sametyildirima/FosFos-AG/README.md

# FosFos-AG
EE463-Hardware Project

This Repo Includes Detailed Information About Hardware Design Project



Video Link: https://www.youtube.com/watch?v=irYZJVu4fXo&feature=youtu.be
