sametyildirima/FosFos-AG/Latex_Report/ee463_hardware.pdf

# EE463 Static Power Conversion AC to DC Motor Drive Project

Ozan Can ˙IY˙IER
Samet YILDIRIM
Furkan KARACABEY

January 2019

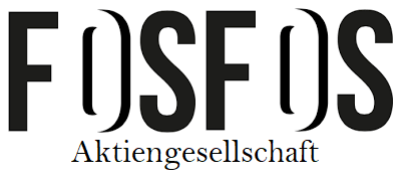
[picture p32: figure]

1

## Contents

1 Introduction | 3
2 Project Description | 3
3 Design Specifications | 7
4 Simulation Results | 8
5 Component Selection | 11
6 Test Results | 12
7 Demonstration Results | 13
8 Cost Analysis | 14
9 Conclusion | 15
10 References | 15

## 1 Introduction

As Static Power Conversion Course project, we are assigned to design an AC to DC Motor Driver which can drive a specified DC motor under full load by controlling the speed. AC input of the system is supplied by a auto-transformer (i.e variac). By using the variac this way, we forced it to act as a fixed transformer. Hence, our product will be able to used industrial purposes.
Power electronics is an area which combines high and low voltages. In our project, we deal with both high and low voltages. By designing our circuit, the most challenging part was controlling the IGBT, because we fed the gate of IGBT with Arduino which drives currents in millimetre level. Unlike control part, we drive the rest of the circuit in 10-20 Ampere levels. In order to protect our Arduino, we used some protection circuits. In addition, the other problem that we faced during design process is over-heating. Because the circuit operates under high voltage and current conditions. All components were on the border of the over-heating. Hence, we added some extra components to prevent over-heating.
During design process, we considered all of the problems and other possible problems that we can face during test. This reports includes related information about problem statement, possible solution approaches, design specifications, simulation,test and demonstration results.

## 2 Project Description

In this project, FOSFOS AG is assigned to drive a Crompton Parkinson DC Motor which is indicated at figure 1.


Figure 1: Crompton Parkinson DC Motor

The ratings of the DC Motor is indicated at following table; Table 1: The Specifications of DC Motor

The input of the project is specified as three or single phase AC grid supplied by variac. The output voltage of the design should be higher than 180Vdc. In addition to these features, the system should (9)control the speed of motor. Heating and isolation conditions of the system also should be sufficient for long term usages.

### 2.1 Solution Approaches

This project has three main topologies to control-drive DC motor. These are three-phase thyristor rectifier, one-phase thyristor rectifier and three-phase diode rectifier with a buck converter. This part of the report includes comparison of these topologies with advantages and disadvantages, simulations of them. Simulations are done by Simulink software. Simulations provide just an example of these topologies with loads.

### 2.1.1 Three-Phase Thyristor Rectifier

This topology which can be seen in figure 2 below includes 6 thyristors. Thyristors must be opened by different gate signals so a fixed delay between the gates is required for switching signals. These gate signals are also used to control DC output.

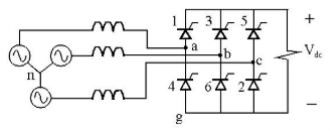
[picture p33: figure]

Figure 2: Three-Phase Thyristor Rectifier

To analyze this topology FosFos AG created a design example on Simulink. This design includes a R load and thyristors have 30-degree firing angle. Figure 3 and 4 shows the schematic of the three-phase thyristor rectifier and output voltage waveform of it.

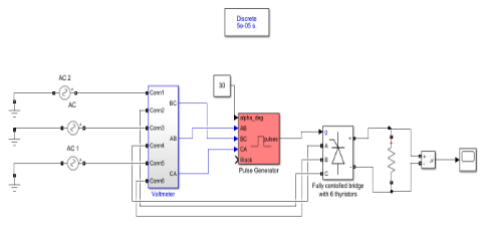
[picture p34: figure]

Figure 3: Simulink Schematic of the Three-Phase Thyristor Rectifier


Figure 4: Output Voltage Waveform of the Three-Phase Thyristor Rectifier

### 2.1.2 One-Phase Thyristor Rectifier

This topology which can be seen in figure 5 below includes 4 thyristors. DC output voltage can be controlled by using two thyristors per half-cycle. Q1-Q4 and Q2-Q3 thyristors are firing together for positive and negative cycle.

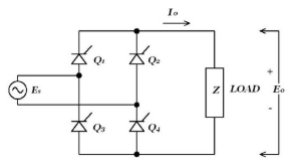
[picture p35: figure]

Figure 5: One-Phase Thyristor Rectifier

Simulink analysis of this topology which is shown in figure 6 was done with R-L Load and the output voltage which includes comparison of input and output can be seen in figure 7.


Figure 6: Simulink Schematic of the One-Phase Thyristor Rectifier


Figure 7: Input-Output Voltage Waveform of the One-Phase Thyristor Rectifier

### 2.1.3 Three-Phase Diode Rectifier & Buck Converter

This topology which can be seen in figure 8 below includes 6 diodes; a switch element which can be Mosfet, IGBT i.e; a freewheeling diode which is conducted when the switch is off; and a LC filter which is used for getting smooth output voltage. Output DC voltage cannot be controlled by bridge rectifier, but it can be controlled by driving switch element’s gate.

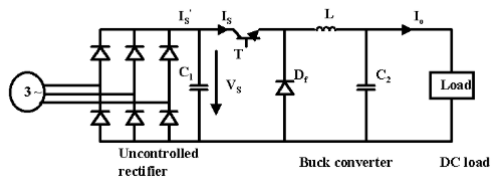
[picture p36: figure]

Figure 8: Three-Phase Diode Rectifier with Buck Converter

Simulation of this topology was done with two filters which are DC Link capacitor and LC filter and an R-L Load. Duty Cycle was selected %45 and the switching frequency was 7800kHz. The schematic of the simulation and graph of the output voltage waveform are shown in figure 9 and 10.


Figure 9: Simulink Schematic of the Three-Phase Diode Rectifier with Buck Converter


Figure 10: Output Voltage Waveform of the Three-Phase Diode Rectifier with Buck Converter

### 2.2 Comparison of Solution Approaches

Table 2:Advantages and Disadvantages of Solution Approaches


## 3 Design Specifications

FosFos AG plans to design cheaper and efficient project for driving DC Motor. Project design of FosFos AG includes a three-phase diode rectifier, a DC link capacitor which is used for filtering the rectifier output, a switch element and a freewheeling diode.In addition to these parts, some modifications are applied to prevent possible issues.For example, LC filter of the output of the buck converter is not included because motor can be considered not only a load but also a filter. The other example of this is in order to prevent over-heating issues power diode and IGBT is connected to a heatsink. The other modification applied is inserting a snubber circuit to prevent overshoot voltages occuring between collector and emittor. To control gate of the switch element, Arduino Nano is selected because it is enough to give switching frequency and size of the component is very suitable for simple design.
Reasons of the rectifier selection can be seen below.
- FosFos AG plans to use smaller passive elements. (One-Phase Thyristor is eliminated)
- FosFos AG plans to design easier control circuit. (Three-Phase Thyristor is eliminated)

## 4 Simulation Results

After deciding three phase diode rectifier and buck converter topology; we focused on simulations in order to determine exact values of each component. We tried to use the most realistic values of each component during simulations because the deviation from ideal results can be very large in real life applications. The simulation circuits and results are indicated at following sections;

### 4.1 Three-Phase Diode Rectifier

Diode bridge rectifier basically operates according to ON/OFF configurations of the diodes. The rectifier topology is indicated at following figure. Two diodes(i.e. one from above and below part of figure 11) conducts at same time.

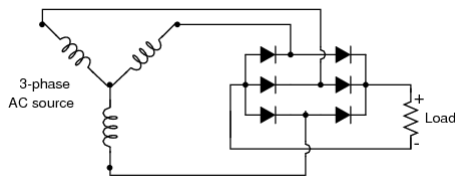
[picture p37: figure]

Figure 11: Rectifier Topology

These changes on conduction determine output voltage waveform. The output waveform operation can be seen from following figure 12. Because the output value of the rectifier is higher than our expected output. We have connected a buck converter to arrange output voltage level. The buck converter operation will be covered at following section.

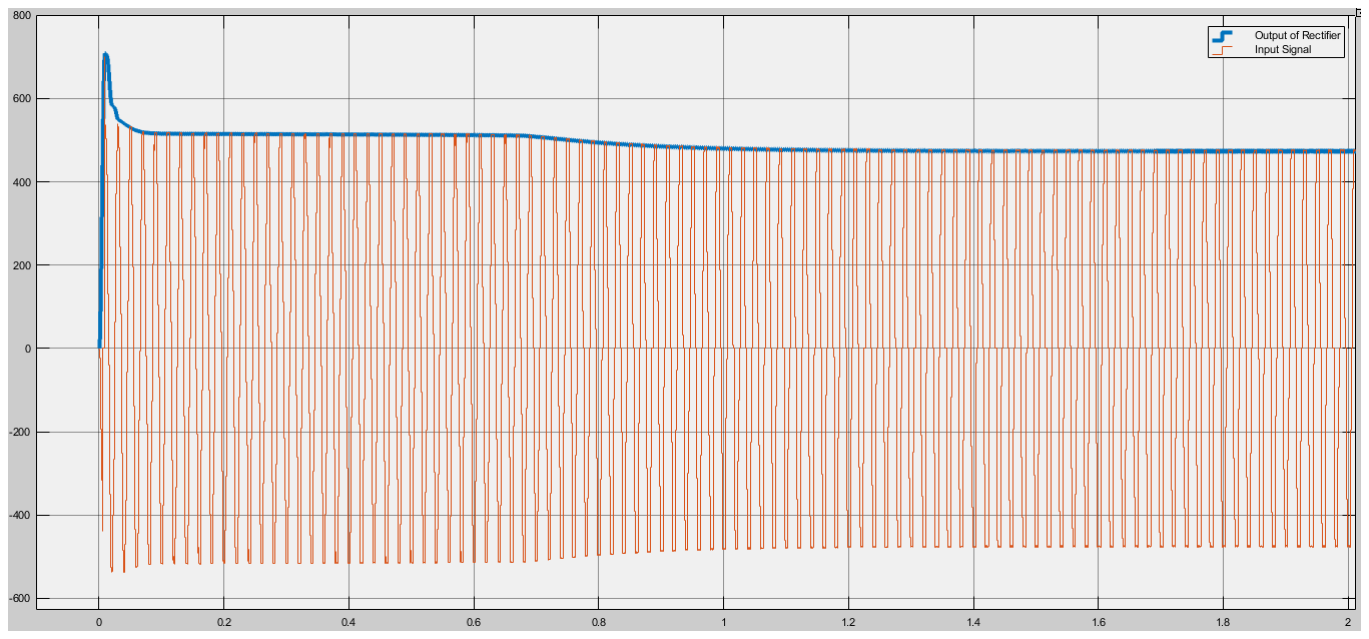
[picture p38: figure]

Figure 12: Rectifier Operation

### 4.2 Buck Converter

The reason of using buck converter in our circuit, which is shown in figure 13 is setting the output voltage to a optimum level by controlling the switching of the IGBT.

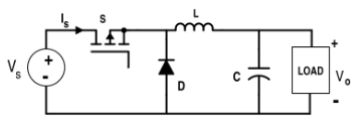
[picture p39: figure]

Figure 13: Buck Converter Topology

The buck converter’s working principle bases on duty cycle of the switching waveform of gate signal. During switch is ON period, the diode goes OFF and we charge our inductor. After then, we discharge our inductor on load and diode during switch is OFF period. The simulation result is indicated at following figure;


Figure 14: Buck Converter Operation

### 4.3 Overall System Results

After obtaining the operations of each subunit; we combined them as an overall system which can be seen from figure 15. The following figures indicates the input output relations of the circuit for different conditions;

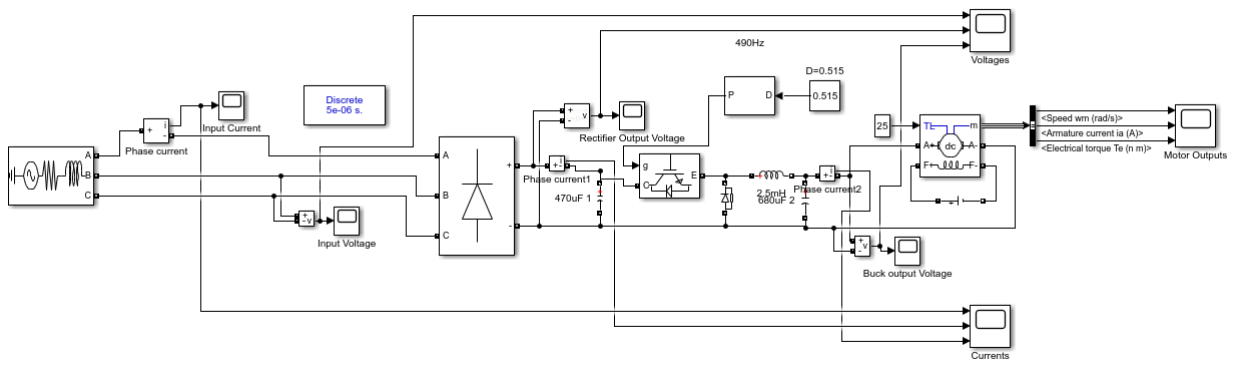
[picture p40: figure]

Figure 15: Overall Circuit

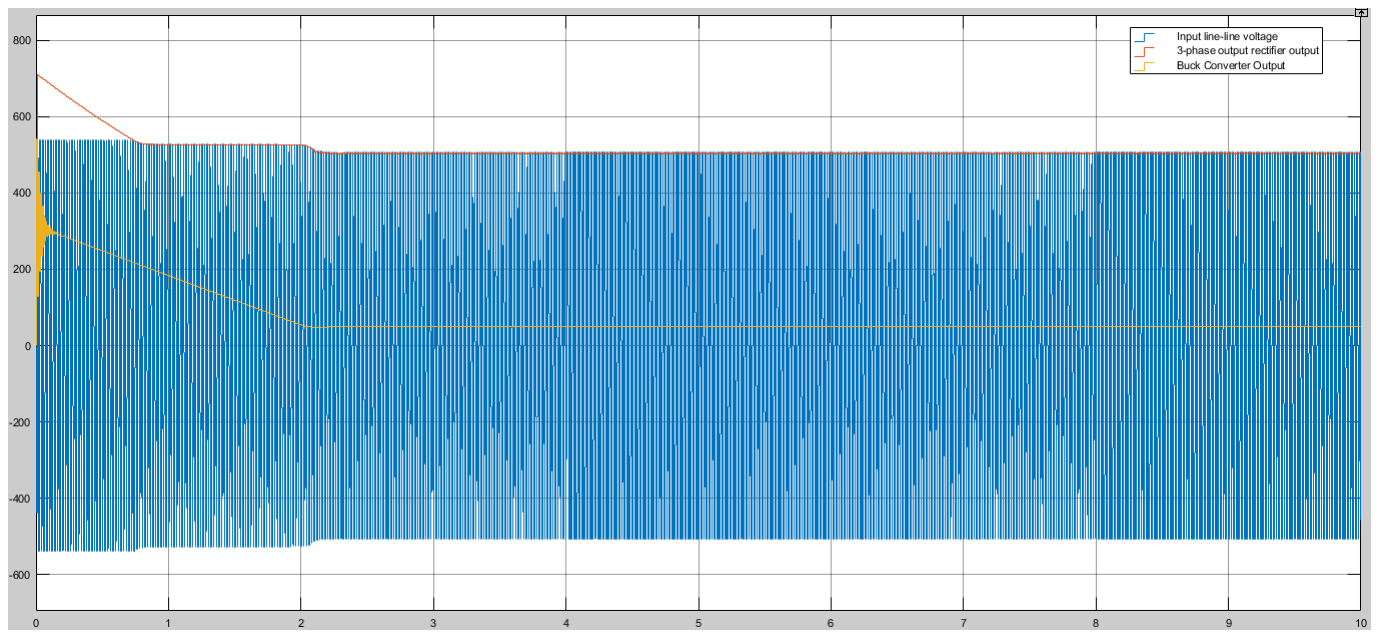
[picture p41: figure]

Figure 16: % 10 Duty Cycle Voltage Output


Figure 17: % 50 Duty Cycle Voltage Output

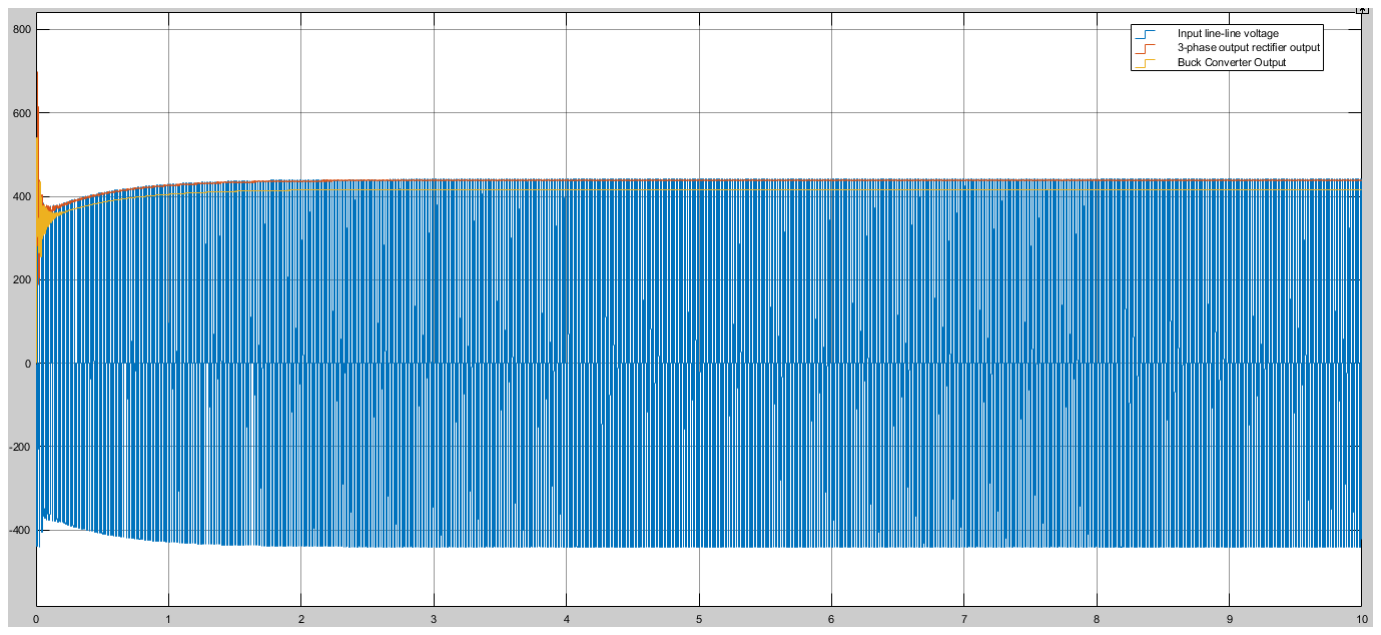
[picture p42: figure]

Figure 18: % 95 Duty Cycle Voltage Output

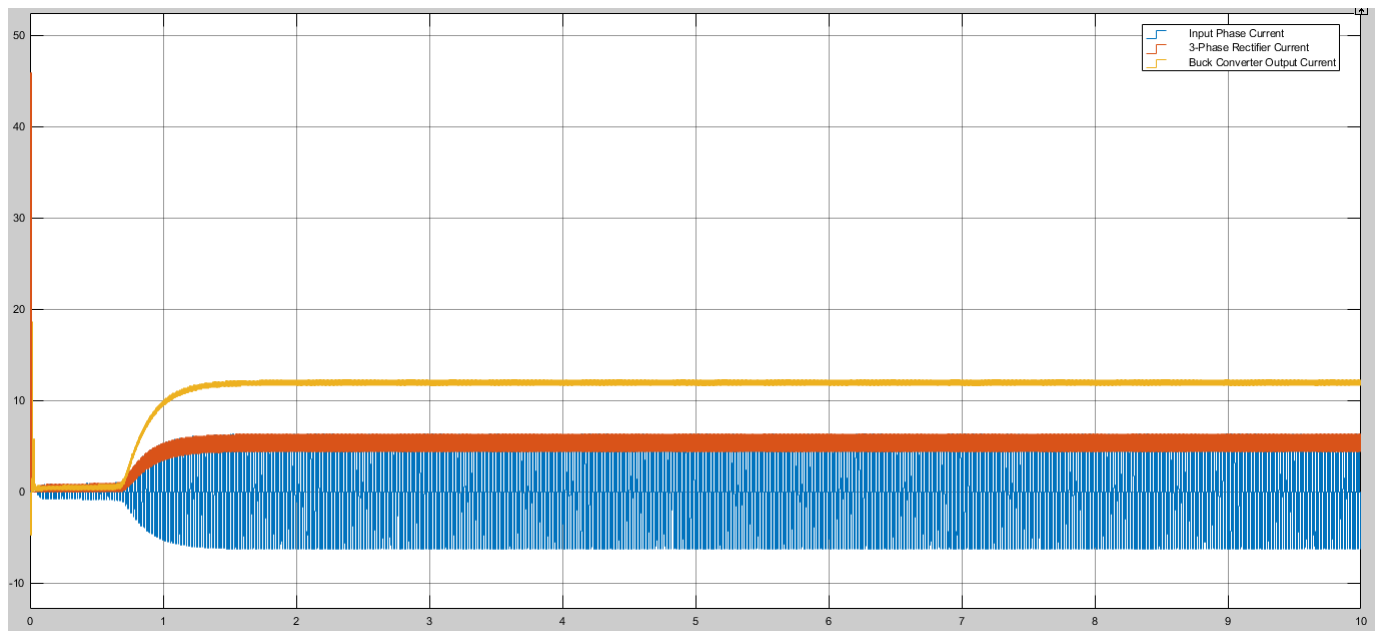
[picture p43: figure]

Figure 19: Current Analysis of Simulation Circuit for % 50 Duty Cycle


Figure 20: Speed-Armature Current-Electrical Torque vs Time Graph

## 5 Component Selection

According to the simulation results we have determined to get components indicated at table 3. While buying the components we were flexible about parameters, because some components are hard to find in local shops.
Table 3: Component List

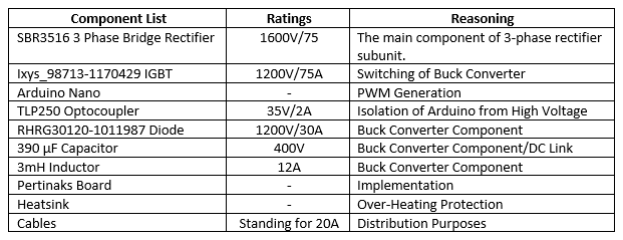
[picture p44: figure]

*For more detailed information, please see our Github repository’s datasheets section.

## 6 Test Results

After component selections; we implemented the circuit on board(can be seen from figure 21) and applied some tests. As seen in figure 22; when output voltage of full bridge rectifier is 232 V; Duty Cycle, Collector to Emitter Voltage and Output Voltage is given in figure 23.


Figure 21: The product during test process


Figure 22: The Measured Output Voltage at Rectifier


Figure 23: The Output Voltage Waveforms

## 7 Demonstration Results

At the final day of the project, we presented our project to the expert. The product is worked well and managed to complete some task such as full loaded working for a while. The following figures show outputs taken during demonstration.


Figure 24: Field and Armature Voltage at Full Load


Figure 25: Armature Current at Full Load Condition


Figure 26: Load Voltage and Load Current


Figure 27: Load Voltage, Current and Power Waveforms

## 8 Cost Analysis

During test process, we have faced lots of problems as expected. Fortunately, we had spare components in order to replace with damaged ones. For example, because of overshoots at VCE voltage, we burnt 4 IGBTs. In addition, we burnt one diode because of high switching frequency. The other problem that we faced is because of a unexpected short circuit, the TLP250 is burnt. Therefore, all these failures became good experiences for us. The finalized version of cost analysis can be seen from following table;
Table 4: Cost Analysis

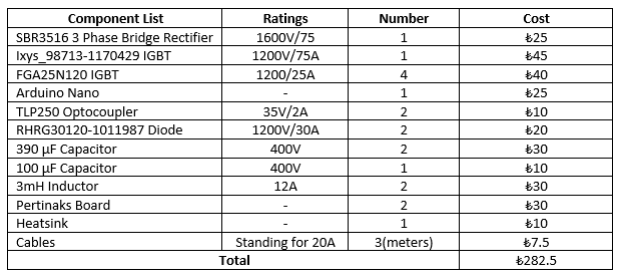
[picture p45: figure]

## 9 Conclusion

We are asked to produce an AC to DC Motor Driver in order to drive a specified DC motor under full load. The speed of the motor also should be controlled by hand. In demonstration, the project is successfully delivered by qualified engineers of FOSFOS Actiengesellschaft.
During this process, we divided our project into subunits to increase ease of understanding concepts. After understanding the project clearly, we went MATLAB/Simulink environment and simulated our design. According to the design, the components of the product is determined. The most challenging part of the project was implementation and testing processes. We have faced too many problems during that period because simulation world is all ideal. The one and most important issue that we faced during testing is over-heating problem. Because we did not use thermal paste between IGBT and heatsink, we lost 4 IGBT’s. The other problem was in simulations that the snubber values of the IGBT is set to be ideal, but in real life it is not. Because of inductive effects in cables, we could not handle this problem at first and lost some IGBTs due to overshooting at voltage. The last problem that we faced is parasitic elements caused some problems. After then, we learned that a practical solution which can solve this problem. By connecting a little capacitor between collector of IGBT and anode of the diode, problems could be solved.
Although project is tiring and hard to create, we learned too many things to use our future engineering life. This project is also helped us to understand the consepts of EE463 Static Power Conversion Course. Finally we would like to thank our Instructors, power elctronics M.S. Students and laboratory technician for their helps.

## 10 References

MOHAN, N. (2017). Power Electronics JOHN WILEY & Sons. http://keysan.me/ee463/
https://github.com/sametyildirima/FosFos-AG.git

## Appendices

Arduino Code for PWM Generation

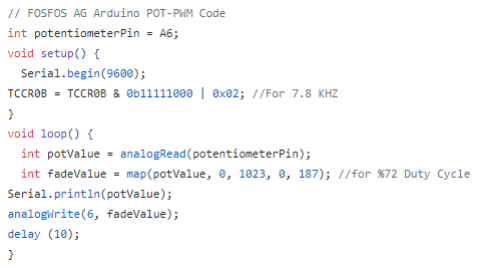
[picture p46: figure]

Datasheets
https://github.com/sametyildirima/FosFos-AG/blob/master/Datasheets/2282907.pdfhttps://github.com/sametyildirima/FosFos-AG/blob/master/Datasheets/2822 7668536.pdf https://github.com/sametyildirima/FosFos-AG/blob/master/Datasheets/FGA25N120.pdfhttps://github.com/sametyildirima/FosFos-AG/blob/master/Datasheets/FGH20N60SFD-D.PDFh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 datasheet en 20170821.pdf https://github.com/sametyildirima/FosFos-AG/blob/master/Datasheets/ixys 98713-1170429.pdf
Video Link(In Turkish) XXXXXXXXXXXXXXXXXXx
