sametyildirima/FosFos-AG/Latex_Report/buck.PNG

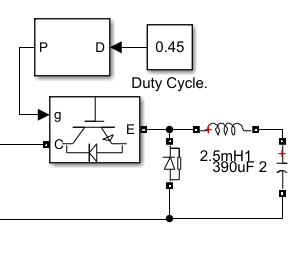
Latex_Report/buck.PNG
