sametyildirima/FosFos-AG/Latex_Report/ucfazdiodecct.PNG

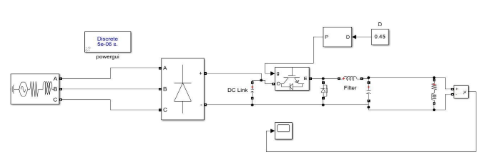
Latex_Report/ucfazdiodecct.PNG
