sametyildirima/FosFos-AG/Latex_Report/ucfazrect.PNG

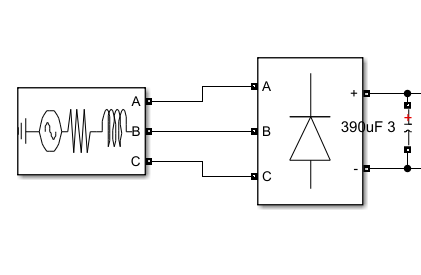
Latex_Report/ucfazrect.PNG
