sametyildirima/FosFos-AG/simulations/One_Phase_Thyristor_Rectifier/Input_Output Voltage.JPG

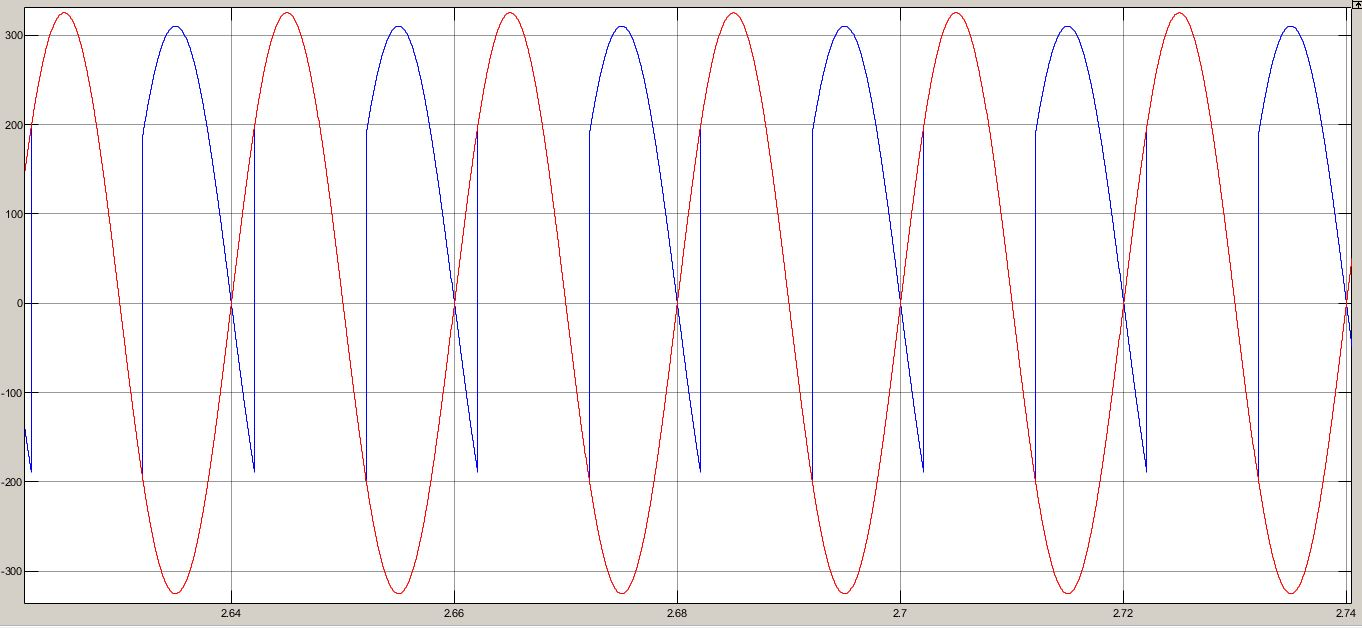
simulations/One_Phase_Thyristor_Rectifier/Input_Output Voltage.JPG
