sametyildirima/FosFos-AG/simulations/One_Phase_Thyristor_Rectifier/Schematic.JPG

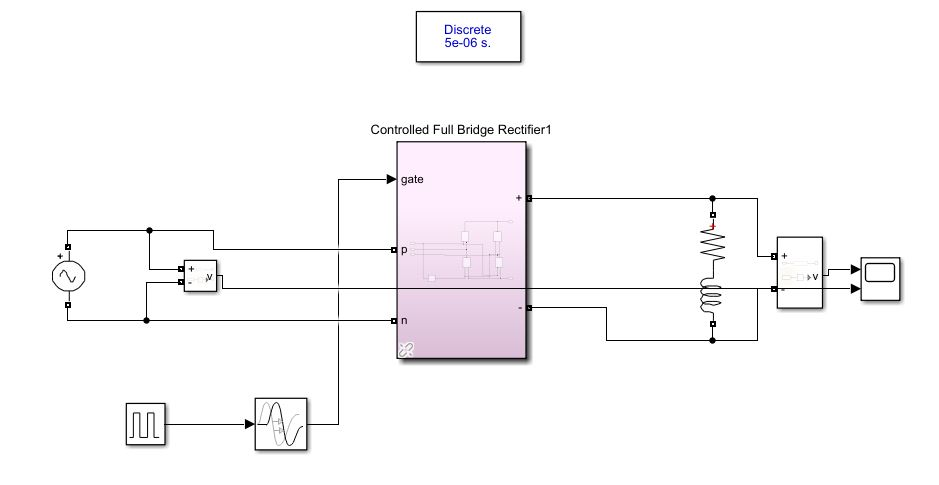
simulations/One_Phase_Thyristor_Rectifier/Schematic.JPG
