sametyildirima/FosFos-AG/simulations/Three Phase Diode Rectifier/Output Voltage.JPG

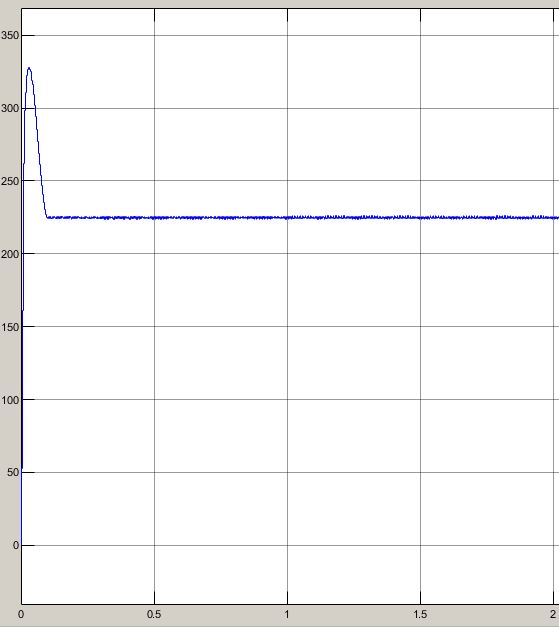
simulations/Three Phase Diode Rectifier/Output Voltage.JPG
