sametyildirima/FosFos-AG/simulations/Three Phase Diode Rectifier/tpdwbc.png

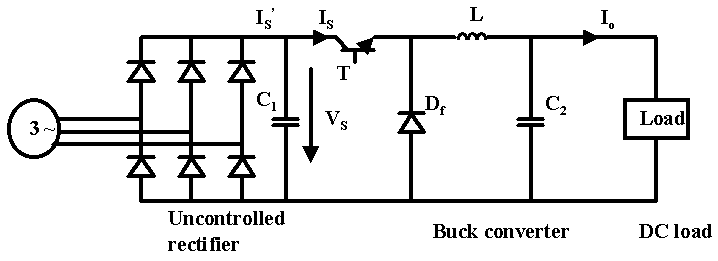
simulations/Three Phase Diode Rectifier/tpdwbc.png
