sametyildirima/FosFos-AG/simulations/Three_Phase_Thyristor_Rectifier/Output Voltage.JPG

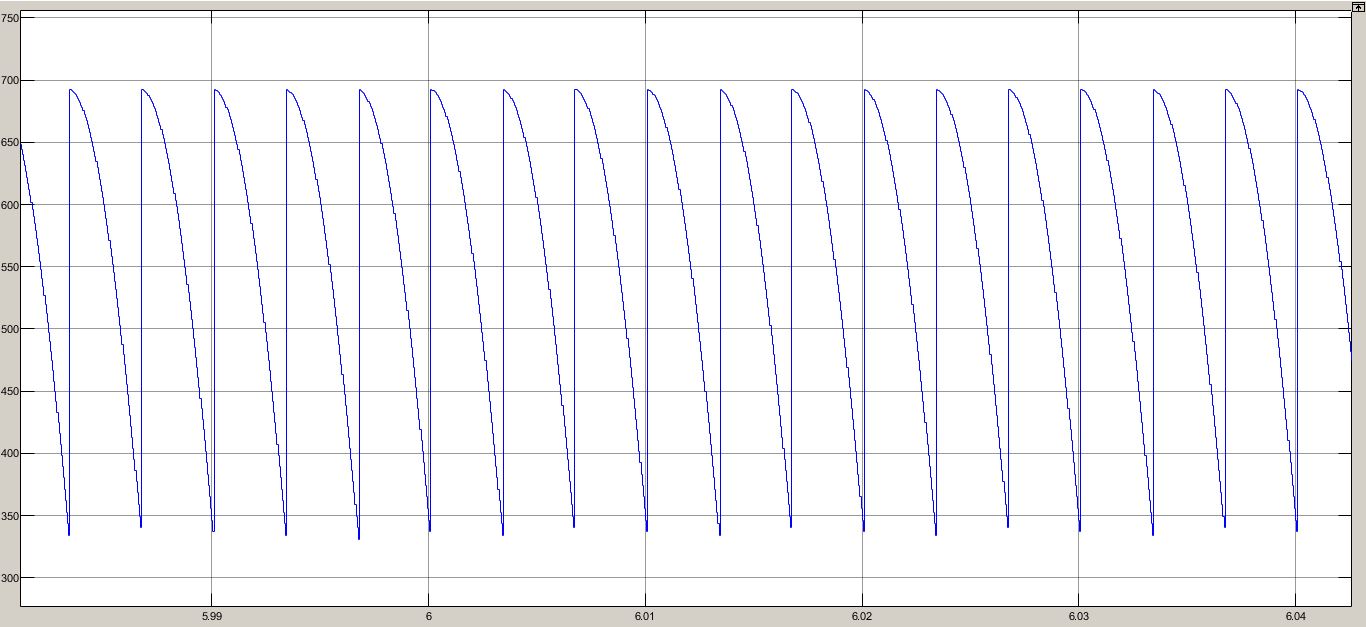
simulations/Three_Phase_Thyristor_Rectifier/Output Voltage.JPG
