sametyildirima/FosFos-AG/simulations/Three_Phase_Thyristor_Rectifier/tptr.JPG

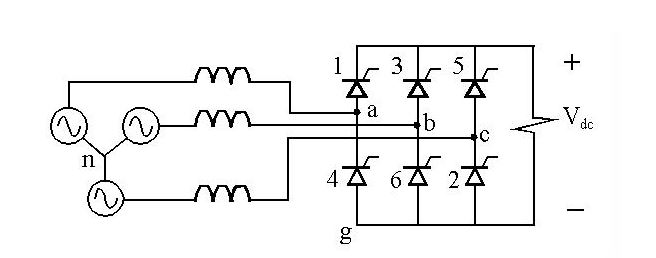
simulations/Three_Phase_Thyristor_Rectifier/tptr.JPG
