sametyildirima/FosFos-AG/(commit log)

2019-01-05 Pre-Design Simulink File is attached
2019-01-10 predesign schematic is added
2019-01-12 Frequency of pwm is determined from this pdf
2019-01-15 Our New Diode
2019-01-21 New Diode
2019-01-22 Arduino Code is added
